cbm-instructions/informatik-rangers/images/circuit.jpg

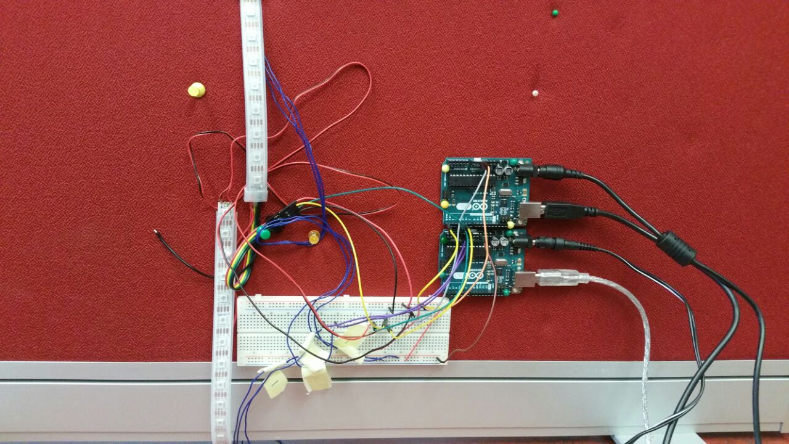
images/circuit.jpg
