cbm-instructions/informatik-rangers/images/prototype.jpg

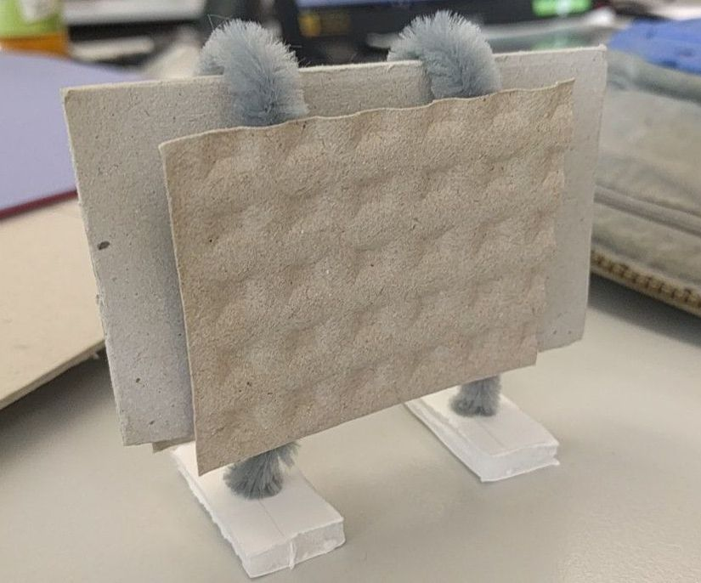
images/prototype.jpg
