cbm-instructions/informatik-rangers/(commit log)

2017-06-27 struktur und materialien hinzugefuegt
2017-06-27 added sound sensor
2017-06-27 added decoration attachment
2017-06-27 added led attachment
2017-06-27 added led steps and picture
2017-06-27 inserted code text
2017-06-27 Anzahl der Pinnadeln und Benötigte Vorkenntnise angepasst
2017-06-27 Update README.md
    Added drahtbrückenkabel to materials
2017-06-27 Kleinere umformulierungen und beseitigung von Rechtschreibfehlern
2017-06-27 Added circuit picture
2017-06-27 Umschrebung von Code und Test, Kalibrierung und Fehlerbehandlung
2017-06-28 Updated Schaltung, Code und Test, Kalibrierung und Fehlerbehandlung
